Ixtalo/GarageSensorNode/garagenode_receiver/README.md

# GarageNode-Receiver

Receiver component.  
GarageNode receiver to publish UART messages to MQTT.

Wiring Sender
