Ixtalo/GarageSensorNode/garagenode_sender/README.md

# GarageNode-Sender

Sender component.

Wiring Sender
