Ixtalo/GarageSensorNode/garagenode_receiver/testing/docker_mqtt/README.md

# Docker MQTT Mosquitto

Docker-Compose to run a local MQTT Mosquitto server, for testing/development purposes.
